peekware/PLFM_RADAR/README.md

# AERIS-10 — Açık Kaynak Faz Dizili RADAR Sistemi

10.5 GHz frekansta çalışan, Darbe Doğrusal Frekans Modülasyonlu (PLFM) faz dizili radar sistemi. İki versiyonda mevcuttur: 3 km ve 20 km menzil. Araştırmacılar, drone geliştiriciler ve SDR meraklıları için tasarlanmış düşük maliyetli açık kaynak platform.

## Özellikler

- **Frekans:** 10.5 GHz (X-Band)
- **Modülasyon:** Darbe Doğrusal Frekans Modülasyonu (LFM)
- **Menzil:** 3 km (düşük güç) / 20 km (yüksek güç)
- **Anten:** 16 elemanlı faz dizili anten array
- **Açık Donanım:** CERN-OHL-P lisanslı

## Proje Yapısı

```
1_Project_Description/          — proje açıklaması ve teknik detaylar
2_Functional Diagram/           — fonksiyonel diyagram ve bağlantı matrisleri
3_Power Management/             — güç yönetimi tasarımı
4_Schematics and Boards/        — şematikler ve PCB yerleşim dosyaları
5_Simulations/                  — RF ve sinyal simülasyonları
6_Application Notes/            — uygulama notları
7_Components Datasheets/        — bileşen datasheetleri
8_Utils/                        — yardımcı araçlar ve görseller
```

## Lisans

- Donanım: CERN-OHL-P v2
- Yazılım: MIT

---

## İletişim

Discord: [https://discord.gg/CNtdPshppv](https://discord.gg/CNtdPshppv)
