peekware/PLFM_RADAR/4_Schematics and Boards Layout/4_7_Production Files/Frequency_Synthesizer/th_.xlsx

JP1 |  | 2X06 | 15.090 | 17.400 | 180.0 | TOP
JP2 |  | 2X07 | 88.550 | 65.980 | 90.0 | TOP
X10 | 22-23-2021 | 22-23-2021 | 4.800 | 30.700 | 270.0 | TOP
X11 | 22-23-2021 | 22-23-2021 | 29.400 | 3.800 | 0.0 | TOP
X12 | 22-23-2021 | 22-23-2021 | 87.800 | 4.100 | 0.0 | TOP
X13 | 22-23-2021 | 22-23-2021 | 12.400 | 95.200 | 180.0 | TOP
X14 | 22-23-2021 | 22-23-2021 | 42.100 | 95.300 | 180.0 | TOP
X15 | 22-23-2021 | 22-23-2021 | 94.000 | 84.500 | 90.0 | TOP
J3 | CJT-T-P-HH-ST-TH1 | CONN_CJT-T-P-XX-ST-TH1_SAI | 78.870 | 47.710 | 270.0 | TOP
J4 | CJT-T-P-HH-ST-TH1 | CONN_CJT-T-P-XX-ST-TH1_SAI | 78.870 | 40.250 | 270.0 | TOP
