peekware/PLFM_RADAR/(commit log)

2026-03-13 refactor(firmware): name adar power sequencing constants
2026-03-13 fix(firmware): propagate gy85 i2c failures
2026-03-15 Fix 6 RTL bugs in FPGA signal processing chain
    - nco_400m_enhanced.v: Correct sine LUT values (3.7x quadrature error)
    - ddc_400m.v: Fix wire forward-declaration (Verilog-2001 compliance)
    - plfm_chirp_controller.v: Remove multi-driven chirp_counter (critical)
    - radar_system_top.v: Fix CFAR wire-as-reg, connect chirp_counter to receiver
    - radar_receiver_final.v: Promote chirp_counter to input port
    All fixes verified with Icarus Verilog 13.0 testbenches (144/144 tests pass).
2026-03-15 Add 8 Verilog testbenches with full coverage (144/144 pass)
    Testbenches for: edge_detector (17), nco_400m (20), cic_decimator (14),
    fir_lowpass (13), freq_matched_filter (14), ddc_400m full-chain (7),
    chirp_controller (39), chirp_contract regression (20).
    Includes CSV output data for waveform verification.
    Add .gitignore to exclude VCD/VVP build artifacts.
2026-03-15 Add 3 missing FPGA modules with enhanced testbenches (168/168 pass)
    Implement the 3 modules identified as missing during repo audit:
    - matched_filter_processing_chain: behavioral FFT-based pulse compression
    - range_bin_decimator: 1024→64 bin decimation with 3 modes + start_bin
    - radar_mode_controller: 4-mode beam/chirp controller
    Wire radar_mode_controller into radar_receiver_final.v to drive the
    previously-undriven use_long_chirp and mc_new_* signals.
    Implement start_bin functionality in range_bin_decimator (was dead code
    in the original interface contract — now skips N input bins before
    decimation for region-of-interest selection).
    Add comprehensive testbenches with Tier 1 confidenc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
2026-03-15 Fix synthesis blockers in 9 RTL files for Vivado compatibility
    Guard all $display/$error/$time calls with ifdef SIMULATION in:
    - chirp_memory_loader_param.v (initial + always block debug prints)
    - cic_decimator_4x_enhanced.v (5 saturation/overflow displays + monitor block)
    - ddc_400m.v (FIR/baseband debug monitor block)
    - fft_1024_inverse.v (IFFT config debug block)
    - matched_filter_multi_segment.v (16 state machine displays + monitor)
    - nco_400m_enhanced.v (initial block debug print)
    - radar_receiver_final.v (frame/chirp counter displays)
    Replace SystemVerilog constructs with Verilog-2001:
    - usb_data_interface.v (typedef enum -> localparam + reg)
    - usb_packet_analyzer.v (typedef enum -> lo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
2026-03-15 Fix 6 RTL files + add xfft_32 stub for successful Vivado synthesis
    Resolves all synthesis errors across attempts 3-11, achieving clean
    Vivado 2025.2 synthesis on XC7A100T (0 errors, 831 LUTs, 320 FFs, 2 DSPs).
    radar_receiver_final.v:
    - reg clk_400m -> wire; output reg -> output wire (x4)
    - Replace ad9484_lvds_to_cmos_400m with ad9484_interface_400m
    - Remove duplicate IBUFDS lvds_to_cmos_400m instantiation
    - Remove non-existent ref_i/ref_q port connections on matched filter
    - Connect adc_dco_bufg as 400MHz clock source
    ad9484_interface_400m.v:
    - Add adc_dco_bufg output port with BUFG instance
    - Route all internal logic through buffered DCO clock
    cic_decimator_4x_enhanced.v:
    - Move reset_mo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
2026-03-15 Fix CDC timing violations: add synchronizers for all inter-clock crossings
    Resolve all 4 inter-clock timing violations found in Vivado synthesis
    attempt #11 (WNS was -2.552 ns). Changes:
    - Add reset synchronizer for clk_120m_dac domain (2-FF chain)
    - Add Gray-code CDC for chirp_counter (6-bit, 120MHz->100MHz)
    - Add single-bit CDC for new_chirp_frame (3-stage, 120MHz->100MHz)
    - Add 2-stage input synchronizers for valid signals in USB module
    (clk_100m->ft601_clk_in) with data capture on rising edge
    - Fix ft601_clk_out multi-driven net (removed duplicate assignment)
    - Update XDC: set_max_delay -datapath_only for CDC, false_path for reset
    Result: Vivado attempt #12 passes with 0 errors, 0 ti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
2026-03-15 Achieve timing closure: DSP48E1 pipelines, 4-stage NCO, 28-bit CIC, ASYNC_REG
    Phase 0+ timing optimization (attempts #13-22 + implementation):
    NCO (nco_400m_enhanced.v):
    - 4-stage pipeline: DSP48E1 accumulate -> LUT read -> negate -> quadrant MUX
    - DSP48E1 phase accumulator in P=P+C mode (eliminates 8-stage CARRY4 chain)
    - Registered phase_inc_dithered to break cascaded 32-bit add path
    DDC (ddc_400m.v):
    - Direct DSP48E1 instantiation for I/Q mixers (AREG=1, BREG=1, MREG=1, PREG=1)
    - CEP=1, RSTP=!reset_n for proper pipeline control
    - 3-stage dsp_valid_pipe for PREG=1 latency
    - Behavioral sim model under ifdef SIMULATION for Icarus compatibility
    CIC (cic_decimator_4x_enhanced.v):
    - 28-bit a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
2026-03-16 Achieve full timing closure on xc7a100tcsg324-1 at 400 MHz (0 violations)
    Complete FPGA timing closure across all clock domains after 9 iterative
    Vivado builds. WNS improved from -48.325ns to +0.018ns (107,886 endpoints).
    RTL fixes for 400 MHz timing:
    - NCO: 6-stage pipeline with DSP48E1 phase accumulator, registered LUT
    index (Fix D splits address decode from ROM read), distributed RAM
    - CIC: explicit DSP48E1 PCOUT->PCIN cascade for 5 integrator stages,
    CREG=1 on integrator_0 to eliminate fabric->DSP setup violation
    - DDC: 400 MHz reset synchronizer (async-assert/sync-deassert),
    active-high reset register for DSP48E1 RST ports, posedge output stage
    - FIR: 5-stage binary adder tree pi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
2026-03-16 Add Phase 0.5 DDC co-simulation suite: bit-accurate Python model, scene generator, and 5/5 scenario validation
    Bit-accurate Python model (fpga_model.py) mirrors full DDC RTL chain:
    NCO -> mixer -> CIC -> FIR with exact fixed-point arithmetic matching
    RTL DSP48E1 pipeline behavior including CREG=1 delay on CIC int_0.
    Synthetic radar scene generator (radar_scene.py) produces ADC test
    vectors for 5 scenarios: DC, single target (500m), multi-target (5),
    noise-only, and 1 MHz sine wave.
    DDC co-sim testbench (tb_ddc_cosim.v) feeds hex vectors through RTL
    DDC and exports baseband I/Q to CSV. All 5 scenarios compile and run
    with Icarus Verilog (iverilog -g2001 -DSIMULATION).
    Comparison framework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
2026-03-16 Add matched-filter co-simulation: bit-perfect validation of Python model vs synthesis-branch RTL (4/4 scenarios, correlation=1.0)
2026-03-16 Fix ddc_input_interface 18->16 bit overflow: add saturation at positive full scale
    Bug: rounding logic 'adc_i <= ddc_i[17:2] + ddc_i[1]' overflows when
    ddc_i[17:2]=0x7FFF and ddc_i[1]=1, causing 0x7FFF+1=0x8000 (sign flip
    from max positive to most negative value).
    Fix: add explicit saturation — clamp to 0x7FFF when truncated value is
    max positive and round bit is set. Negative values cannot overflow since
    rounding only moves toward zero.
    New testbench: tb_ddc_input_interface.v with 26 tests covering rounding,
    truncation, overflow saturation at positive boundary, negative full scale,
    valid synchronization, and sync error detection.
2026-03-16 Fix multi-seg/chain handshake deadlock + add radar_receiver_final integration test (10/10 PASS)
    RTL fix: matched_filter_multi_segment.v ST_WAIT_FFT now waits for
    processing chain to complete ALL 1024 outputs and return to IDLE
    before advancing to next segment. Previously, it transitioned on the
    first fft_pc_valid edge, causing the chain to still be outputting
    while multi-seg started collecting data for the next segment. This
    broke the handshake and caused permanent deadlock after segment 0.
    Also fixes forward reference of sample_addr_from_chain in
    radar_receiver_final.v (declaration moved before first use).
    New files:
    - tb/tb_radar_receiver_final.v: P0 integration test for full RX
    pipeli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
2026-03-16 Fix RTL Bug #3: S_IDLE->S_ACCUMULATE now writes first sample immediately
    Previously the S_IDLE->S_ACCUMULATE transition consumed one data_valid
    cycle without writing to BRAM, losing the first sample. The testbench
    worked around this by sending sample[0] twice.
    Fix: drive mem_we + data capture in S_IDLE on the transition cycle and
    advance write_range_bin to 1. Testbench workaround removed.
    Verified: 3/3 Doppler co-sim BIT-PERFECT, integration test 10/10 PASS.
2026-03-16 Fix overlap-save: fill full 1024-sample buffer per segment, zero-pad last partial segment
    Previously segment 0 only filled positions [0:895], leaving [896:1023]
    as zeros from the initial block. These zeros propagated into the overlap
    region of subsequent segments, corrupting the convolution.
    Fix: change buffer-full threshold from SEGMENT_ADVANCE (896) to
    BUFFER_SIZE (1024). Add zero-padding for the last segment when chirp
    data runs out before the buffer is full. Updated testbench accordingly.
    Verified: multi-segment 32/32 PASS, integration test 10/10 PASS.
2026-03-16 Fix P0/P1 RTL bugs found during pre-hardware audit
    P0-1: nco_400m_enhanced.v — DSP48E1 OPMODE corrected from PCIN to P
    feedback (was routing stale cascade data into accumulator)
    P0-2: radar_receiver_final.v — removed same-clock CDC that corrupted
    ADC data path between ad9484_interface and DDC
    P1-5: fir_lowpass.v — fixed zero replication count in coefficient
    symmetric extension ({0{1'b0}} is empty, now uses explicit 0)
    Also updates .gitignore to exclude debug/scratch artifacts.
    All 30+ testbenches pass (unit, co-sim, integration).
2026-03-16 Migrate hardware platform from XC7A50T to XC7A200T-2FBG484I
    Production FPGA: Artix-7 XC7A200T-2FBG484I (33,650 slices, 740 DSP48E1,
    365 BRAM, -2 speed grade). Pin-mapped across 6 banks with proper VCCO
    assignment (3.3V/2.5V/1.8V).
    RTL timing primitives added for clean timing closure:
    - ad9484_interface_400m.v: BUFIO for IDDR capture at 400MHz DDR,
    BUFG for fabric logic, reset synchronizer (P1-7)
    - dac_interface_single.v: ODDR for dac_clk forwarding + dac_data[7:0]
    output registration, eliminates clock-forwarding insertion delay
    - usb_data_interface.v: ODDR for ft601_clk_out forwarding, FSM runs
    on ft601_clk_in domain with CDC synchronizers
    Constraints:
    - New production XDC (xc7a200t_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
2026-03-16 Fix XDC for timing closure: add hold waivers, remove stale constraints
    Build 3 on XC7A200T-2FBG484I achieves full timing closure:
    - WNS +0.040ns (setup), WHS +0.036ns (hold), 0 failing endpoints
    - Add 3 hold false-path waivers for ODDR/BUFIO I/O boundaries
    (DAC clk_120m→dac_clk_fwd, FT601 ft601_clk_in→ft601_clk_fwd,
    ADC adc_d_p→adc_dco_p) — all artifacts of STA modeling
    - Comment out ft601_be[2:3] pins (RTL only drives [1:0])
    - Remove CIC multicycle paths (DSP48E1 cells not matchable)
    - Add -quiet to IOB properties for tristate/optimized registers
2026-03-16 Widen ft601_be to [3:0] for 32-bit FT601 mode, fix NCO XSim TB
    - Expand ft601_be from [1:0] to [3:0] across RTL, top-level, testbenches,
    and XDC (uncomment be[2:3] pin assignments B21/A21)
    - Fix NCO XSim testbench: correct reset check (0x7FFF not 0), add pipeline
    warmup and sample skip for DSP48E1 quadrature test
    - All local regression tests pass (39/39 USB, 10/10 integration, all co-sim)
2026-03-16 Fix NCO XSim test 12: add pipeline warmup and sample skip for 1 MHz zero-crossing test
2026-03-17 Added all boards stack
2026-03-17 Add SymbiYosys formal verification for 6 modules, fix 2 doppler bugs
    Formal verification (SymbiYosys + smtbmc/z3):
    - cdc_single_bit: BMC PASS depth 80, cover PASS 3/3
    - cdc_handshake: BMC PASS depth 100, cover PASS 4/4
    - cdc_adc_to_processing: BMC PASS depth 80, cover PASS
    - radar_mode_controller: BMC PASS depth 200, cover PASS 8/8
    - range_bin_decimator: cover PASS 7/7, BMC running (step 61+)
    - doppler_processor: cover running (step 133/150), BMC running (step 35+)
    DUT bug fixes found by formal:
    - doppler_processor: write_chirp_index overflow past CHIRPS_PER_FRAME-1
    in S_ACCUMULATE frame-complete branch (reset to 0)
    - doppler_processor: read_doppler_index unclamped prefetch in S_LOAD_FFT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
2026-03-17 Fix all 10 CDC bugs from report_cdc audit, add overflow guard in range_bin_decimator
    CDC fixes across 6 RTL files based on post-implementation report_cdc analysis:
    - P0: sync stm32_mixers_enable and new_chirp_pulse to clk_120m via toggle CDC
    in radar_transmitter, add ft601 reset synchronizer and USB holding
    registers with proper edge detection in usb_data_interface
    - P1: add ASYNC_REG to edge_detector, convert new_chirp_frame to toggle CDC,
    fix USB valid edge detect to use fully-synced signal
    - P2: register Gray encoding in cdc_adc_to_processing source domain, sync
    ft601_txe and stm32_mixers_enable for status_reg in radar_system_top
    - Safety: add in_bin_count over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
2026-03-17 Fix range_bin_decimator overflow guard priority bug: group completion now takes precedence over overflow guard in ST_PROCESS, ensuring all OUTPUT_BINS outputs are emitted when sufficient input sample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
2026-03-17 Fix CDC reset domain bug (P0), strengthen testbenches with 31 structural assertions
    Split cdc_adc_to_processing reset_n into src_reset_n/dst_reset_n so source
    and destination clock domains use correctly-synchronized resets. Previously
    cdc_chirp_counter's destination-side sync chain (100MHz) was reset by
    sys_reset_120m_n (120MHz domain), causing 30 CDC critical warnings.
    RTL changes:
    - cdc_modules.v: split reset port, source logic uses src_reset_n,
    destination sync chains + output logic use dst_reset_n
    - radar_system_top.v: cdc_chirp_counter gets proper per-domain resets
    - ddc_400m.v: CDC_FIR_i/q use reset_n_400m (src) and reset_n (dst)
    - formal/fv_cdc_adc.v: updated wrapper for new port i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
2026-03-17 Convert async→sync reset on DSP/BRAM datapath registers for timing closure
    P1-CRITICAL: doppler_processor.v — split FSM into control (async reset)
    and BRAM/DSP datapath (sync reset) blocks. Fixes REQP-1839/1840 BRAM
    address register corruption risk; enables DSP48 absorption of window
    multipliers (mult_i/q).
    P1-CRITICAL: frequency_matched_filter.v — convert all 4 pipeline stages
    (input capture, multiply, add, saturate) from async to sync reset.
    Enables DSP48E1 absorption of complex multiplier registers.
    P1-HIGH: fir_lowpass.v — convert adder tree (L0-L4), output stage, and
    valid pipeline from async to sync reset. Fixes 856 DPOR-1 warnings
    (428 per FIR instance × 2 I/Q channels), en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
2026-03-17 Split fft_engine FSM: async reset for control, sync reset for DSP/BRAM datapath (Build 11)
    Split monolithic always block into two:
    - Block 1 (async reset): FSM state, counters, output interface
    (dout_re/im, dout_valid, done) — deterministic startup
    - Block 2 (sync reset): DSP/BRAM pipeline registers (rd_b_re/im,
    rd_tw_cos/sin, bf_prod_re/im, rd_a_re/im, bf_t_re/im, rd_tw_idx,
    rd_addr_even/odd, rd_inverse) — enables hard block absorption
    Also convert output pipeline (out_pipe_valid/inverse) to sync reset.
    Expected synthesis impact:
    - DSP48E1 AREG/BREG absorption for butterfly multiply inputs
    - DSP48E1 PREG absorption for multiply outputs (bf_prod_re/im)
    - BRAM output register abso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
2026-03-17 Improve timing margins with targeted datapath register tuning
    Reduce routing pressure on CIC/NCO critical paths and move Doppler BRAM read-address registers to sync-reset datapath logic so Build 13 closes with stronger setup/hold slack while preserving functional behavior.
2026-03-17 Phase 1 hardware bring-up prep: ILA debug probes, CDC waivers, programming scripts
    - Rename latency_buffer_2159 -> latency_buffer (module + file + all refs)
    - Add CDC waivers for 5 verified false-positive criticals to XDC
    - Add ILA debug probe insertion script (4 cores, 126 probe bits, 2 clock domains)
    - Add FPGA programming script (7-step flow with DONE pin verification)
    - Add ILA capture script (4 scenarios + health check, CSV export)
    - Add debug_ila.xdc with MARK_DEBUG fallback attributes
    - Full regression clean: 13/13 suites, 266/266 checks, 2048/2048 golden match
2026-03-18 Fix ILA probe insertion script: deferred core creation, exact-path net resolution, Vivado 2025.2 MU_CNT minimum
2026-03-18 Add TE0712/TE0701 split target with dedicated top, XDC, and build flow
2026-03-18 Add GitHub Pages docs site for antenna and simulation reports
2026-03-18 Publish Simulation Report v2 aligned to current FPGA baseline
2026-03-19 Add bring-up diagnostic instrumentation to clocking/LO subsystem and main init
    Observe-before-fix instrumentation for bench bring-up: adds timestamped
    DIAG logging to the AD9523 clock config, ADF4382A LO manager, power
    sequencing, lock monitoring, temperature monitoring, and safe-mode entry.
    Annotates known bugs (double ad9523_setup call, timed-sync init ordering,
    TriggerTimedSync no-op, phase-shift before init-check, last_check timer
    collision) without changing any runtime behavior.
2026-03-19 Add DIAG instrumentation to beamformer, PA, USB, and remaining main.cpp subsystems
    Completes the observe-before-fix instrumentation pass across all critical
    firmware subsystems:
    - ADAR1000_Manager.cpp: 99 DIAG calls covering power-up/down, TX/RX mode
    switching, ADTR1107 init sequence, SPI transfers, ADC reads (with 100ms
    timeout guard on unbounded busy-wait), and scratchpad verification.
    - DA5578.c: 21 DIAG calls on init, reset, channel writes, clear pin
    activation, and I2C error paths.
    - ADS7830.c: DIAG on init (with test-read verification) and I2C
    transmit/receive error logging in single-ended and differential reads.
    - USBHandler.cpp: DIAG on state transitions, start flag detectio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
2026-03-19 Add MCU firmware test harness with 8 bug-confirming tests
    Complete test infrastructure for the observe-before-fix methodology:
    - stm32_hal_mock: HAL stub types + spy/recording ring buffer (512 entries)
    - ad_driver_mock: ADF4382/AD9523 mock drivers with configurable returns
    - 9 shim headers redirecting real #includes to mock types
    - Makefile with individual (test_bug1..8) and aggregate (test) targets
    All 8 tests pass, confirming:
    #1 Timed sync init ordering (SetupTimedSync before initialized=true)
    #2 AD9523 double setup (first call before reset release)
    #3 TriggerTimedSync no-op (prints messages, no HW action)
    #4 Phase shift before init error check
    #5 SetFinePhaseShift GPIO-only p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
2026-03-19 Fix all 8 firmware bugs with regression tests
    Bugs fixed in adf4382a_manager.c:
    - Bug #1: Move initialized=true before sync setup, propagate sync failure
    - Bug #3: Implement TriggerTimedSync with sw_sync pulse (was no-op)
    - Bug #5: Replace GPIO-only placeholder with TIM3 PWM for DELADJ
    - Bug #7: Correct GPIOG pin definitions to match CubeMX (pins 6-15)
    Bugs fixed in main.cpp:
    - Bug #2: Remove pre-reset ad9523_setup() call (keep only post-reset)
    - Bug #4: Move init error check before phase shift calls
    - Bug #6: Fix timer variable (last_check -> last_check1) in temp block
    - Bug #8: Uncomment uart_print/uart_println debug helpers
    Test harness updates:
    - All 8 tests rewritten to assert correct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
2026-03-19 Fix SPI bugs #9 (NULL platform_ops) and #10 (missing CS toggle), widen chip_select to uint16_t
    Bug #9: Both TX and RX SPI init params had platform_ops = NULL, causing
    adf4382_init() -> no_os_spi_init() to fail with -EINVAL. Fixed by setting
    platform_ops = &stm32_spi_ops and passing stm32_spi_extra with correct CS
    port/pin for each device.
    Bug #10: stm32_spi_write_and_read() never toggled chip select. Since TX
    and RX ADF4382A share SPI4, every register write hit both PLLs. Rewrote
    stm32_spi.c to assert CS LOW before transfer and deassert HIGH after,
    using stm32_spi_extra metadata. Backward-compatible: legacy callers
    (e.g., AD9523) with cs_port=NULL skip CS management.
    Also widened chip_sele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
2026-03-19 Fix Bug #11 (platform SPI transmit-only), FPGA B2 (chirp BRAM migration), FPGA B3 (DSP48 pipelining)
    Bug #11: platform_noos_stm32.c used HAL_SPI_Transmit instead of
    HAL_SPI_TransmitReceive — reads returned garbage. Changed to in-place
    full-duplex. Dead code (never called), fixed per audit recommendation.
    Test added: test_bug11_platform_spi_transmit_only.c. Mock infrastructure
    updated with SPI spy types. All 11 firmware tests pass.
    FPGA B2: Migrated long_chirp_lut[0:3599] from ~700 lines of hardcoded
    assignments to BRAM with (* ram_style = "block" *) attribute and
    $readmemh("long_chirp_lut.mem"). Added sync-only read block for proper
    BRAM inference. 1-cycle read latency introduced. short_c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
2026-03-19 Fix bugs B12-B17 (PA cal loop, ADC buffer, DIAG_SECTION args, htim3 init, stale annotations) with regression tests
    B12: PA IDQ calibration loop condition inverted (< 0.2 -> > 0.2) for both DAC1/DAC2
    B13: DAC2 ADC buffer mismatch — reads from hadc2 now correctly stored to adc2_readings
    B14: DIAG_SECTION macro call sites changed from 2-arg to 1-arg form (4 sites)
    B15: htim3 definition + MX_TIM3_Init() added (PWM mode, CH2+CH3, Period=999)
    B16: Removed stale NO-OP annotation on TriggerTimedSync (already fixed in Bug #3)
    B17: Updated stale GPIO-only warnings to reflect TIM3 PWM implementation (Bug #5)
    All 15 tests pass (11 original + 4 new for B12-B15).
2026-03-19 CIC comb pipeline registers, BUFG sim guard, system TB fix, regression runner
    - cic_decimator_4x_enhanced.v: Add integrator_sampled_comb and
    data_valid_comb_pipe pipeline stages between integrator sampling and
    comb computation to break the critical path (matches remote 40cda0f)
    - radar_system_top.v: Wrap 3 BUFG instances in ifdef SIMULATION guard
    with pass-through assigns for iverilog compatibility
    - radar_system_tb.v: Convert generate_radar_echo function to task and
    move sin_lut declaration before task (iverilog declaration-order fix),
    add modular index clamping to prevent LUT out-of-bounds
    - run_regression.sh: Automated regression runner for all 18 FPGA
    testbenches with --quick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
2026-03-19 Fix matched filter golden test paths (40/40 pass, was 37/40)
2026-03-19 Wire matched filter range profile to USB, replacing Doppler placeholder
2026-03-19 Add board-day worksheet and cross-link bring-up docs
2026-03-19 Add FMC-path FT601 XDC for TE0713+TE0701+UMFT601X-B pin mapping
    Maps all 47 FT601 signals through FMC LPC J10 to correct FPGA pins:
    - DATA[31:0] + D_CLK: Bank 15 (LA17-LA33)
    - BE_N[3:0], control, status: Bank 16 (LA00-LA15)
    Both banks share VIOTB rail — set to 3.3V for LVCMOS33.
    Includes timing constraints and RTL adaptation notes.
2026-03-19 Add UART diagnostic capture tool for board-day bring-up
    - Python/pyserial script captures STM32 USART3 DIAG output (115200 8N1)
    - Auto-detects serial port on macOS (ST-Link VCP, FTDI, CH340, CP210x)
    - Color-coded terminal output by subsystem and severity
    - Simultaneous logging to timestamped file in logs/
    - Filtering by subsystem tag (--filter LO,PA) or severity (--errors-only)
    - Parses all DIAG macro formats: DIAG, DIAG_WARN, DIAG_ERR, DIAG_SECTION
    - Capture stats summary on exit (line counts by subsystem, error/warning totals)
    - logs/ added to .gitignore
2026-03-19 Update heartbeat dev target: LVCMOS33 for Bank 16 FT601 compat, add comments
    - Changed user_led/system_status IOSTANDARD from LVCMOS25 to LVCMOS33
    to match VIOTB=3.3V needed for FT601 on Bank 16
    - Added register init value for hb_counter
    - Added comments documenting clock source (50 MHz FIFO0CLK at U20, Bank 14)
    and expected LED toggle rates
2026-03-19 Update ILA probe script references from Build 13 to Build 16
2026-03-19 FIR DSP48 pipelining (BREG+MREG) + matched filter BRAM migration with overlap cache
    FIR: Add coeff_reg/mult_reg pipeline stages to fix 68 DPIP-1 + 35 DPOP-2
    DRC warnings. Valid pipeline widened 7→9 bits (+2 cycle latency).
    Matched filter: Migrate input_buffer_i/q from register arrays to BRAM
    (~33K FF savings). Overlap-save uses register cache captured during
    ST_PROCESSING to avoid BRAM read/write conflicts during overlap copy.
    New ST_OVERLAP_COPY state writes cached tail samples back sequentially.
    Both changes pass 18/18 FPGA regression. Golden data regenerated for
    +2 FIR latency baseline.
2026-03-19 Fix matched filter synth errors: overlap_copy_count part-select width, add FSM default
    Vivado 2025.2 (Synth 8-524): overlap_copy_count is 8-bit but [9:0]
    part-select was 10-bit. Changed to explicit zero-extend concat.
    Added default case to FSM to suppress non-full case warning.
2026-03-19 Add Phase 0 Vivado-style lint to regression runner, update golden data
    Adds two-layer lint pass (iverilog -Wall + custom static checks) that
    catches part-select OOB errors and case-without-default warnings before
    pushing to remote Vivado. Catches the exact Synth 8-524 class error that
    broke Build 18 initial attempt. Lint errors abort regression; warnings
    are advisory. Regenerated golden data for BRAM-migrated matched filter.
2026-03-19 Gap 3 Safety Architecture: IWDG watchdog, Emergency_Stop PA rail cutoff, temp max, periodic IDQ re-read, emergency state ordering + 5 tests (20/20 pass)
2026-03-19 Gap 7 MMCM jitter cleaner + CIC comb CREG pipeline + XDC clock-name fix
    MMCM (Gap 7):
    - Add adc_clk_mmcm.v: MMCME2_ADV wrapper (VCO=800MHz, CLKOUT0=400MHz)
    - Modify ad9484_interface_400m.v: replace BUFG with MMCM path, gate reset on mmcm_locked
    - Add adc_clk_mmcm.xdc: CDC false paths for clk_mmcm_out0 <-> clk_100m
    XDC Fix (Build 19 WNS=-0.011 root cause):
    - Remove conflicting create_generated_clock -name clk_400m_mmcm
    - Replace all clk_400m_mmcm references with Vivado auto-generated clk_mmcm_out0
    - CDC false paths now correctly apply to actual timing paths
    CIC CREG Pipeline (Build 18 critical path fix):
    - Explicit DSP48E1 for comb[0] with CREG=1/AREG=1/BREG=1/PREG=1
    - Absorbs integrator_sa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
2026-03-19 Gap 4 USB Read Path: wire host-to-FPGA command path with toggle CDC, add read path tests
    - usb_data_interface.v: Add FT601 read FSM (RD_IDLE/OE_ASSERT/READING/
    DEASSERT/PROCESS) + cmd_data/valid/opcode/addr/value output ports
    - radar_system_top.v: Connect cmd_* ports from usb_inst, add toggle CDC
    for cmd_valid (ft601_clk -> clk_100m), add command decode registers
    (mode/trigger/cfar_threshold/stream_control), wire host_mode and
    host_trigger to rx_inst
    - radar_receiver_final.v: Add host_mode[1:0] and host_trigger input
    ports, replace hardcoded mode/trigger in radar_mode_controller instance
    - tb_usb_data_interface.v: Connect cmd_* ports, add host data bus driver,
    add Test Groups 12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
2026-03-19 Update docs for Build 20 (v0.1.3-build20) stable release + Gaps 3-7 status
    - release-notes.html: Add commits for Gaps 3-5-7-4, tagged releases table,
    architectural gap status table, updated GitHub links
    - implementation-log.html: Add Build 20/19/18 timeline entries, Gap 3-4-5
    milestones, updated quality/build history sections
    - reports.html: Update FPGA status to Build 20 baseline, MCU regression
    to 20/20, report currency notice with current gap status
2026-03-19 Gap 2 GUI Settings: runtime chirp timing, stream control gating, status readback (18/18 FPGA, 20/20 MCU)
    Register map: 0x10-0x15 chirp timing overrides, 0xFF status readback,
    0x03 CFAR threshold now wired to actual compare, 0x04 stream control
    gates USB write FSM. Status readback sends 7-word packet (0xBB header,
    5 status words, 0x55 footer) via toggle CDC.
    radar_mode_controller: 6 cfg_* input ports replace hardcoded parameters.
    usb_data_interface: stream_control CDC, status_request toggle CDC,
    SEND_STATUS state (3'd7), stream gating in IDLE/HEADER/RANGE/DOPPLER.
    radar_system_top: 6 host registers + command decode for 0x10-0x15/0xFF.
    radar_receiver_final: 6 host_* timing passthrough ports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
2026-03-19 FFT engine: merge SHIFT into WRITE (5→4 cycle butterfly, 20% throughput) + barrel-shift twiddle index
    Opt 1: Eliminated ST_BF_SHIFT state — arithmetic right-shift is pure
    bit-selection (zero logic levels), merged into BF_WRITE combinational
    add/subtract. Saves LOG2N * N/2 = 5120 cycles per 1024-pt FFT.
    Opt 2: Replaced idx_val * tw_stride_reg general multiply with
    idx_val << (LOG2N-1-stage) barrel shift. tw_stride_reg is always a
    power of 2, so this is mathematically identical and frees a multiplier.
    Regression: 18/18 FPGA pass (bit-exact results).
2026-03-19 E2E integration test + RTL fixes: mixer sequencing, USB data-pending flags, receiver toggle wiring (19/19 FPGA)
    RTL fixes discovered via new end-to-end testbench:
    - plfm_chirp_controller: TX/RX mixer enables now mutually exclusive
    by FSM state (Fix #4), preventing simultaneous TX+RX activation
    - usb_data_interface: stream control reset default 3'b001 (range-only),
    added doppler/cfar data_pending sticky flags, write FSM triggers on
    range_valid only — eliminates startup deadlock (Fix #5)
    - radar_receiver_final: STM32 toggle signals wired through for mode-00
    pass-through, dynamic frame detection via host_chirps_per_elev
    - radar_system_top: STM32 toggle signal wiring to receiver instan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
2026-03-19 Fix Vivado DRC: consolidate data_pending flags into single always block, fix MMCM LOCKED false_path
    usb_data_interface.v: doppler_data_pending and cfar_data_pending were
    driven by two always blocks (CDC sync block set them, write FSM cleared
    them). Vivado DRC MDRV-1 flagged this as multiple drivers. Moved all
    set/clear logic into the write FSM always block using doppler_valid_ft
    and cfar_valid_ft edge wires.
    adc_clk_mmcm.xdc: changed set_false_path -from to -through for MMCM
    LOCKED pin (not a valid timing startpoint). Eliminates CRITICAL WARNING
    from Builds 19/20/21.
    19/19 FPGA regression pass.
2026-03-20 Build 21 docs + TCL fix: WNS +0.156ns, 139 DSP, tag v0.1.4-build21
    Build 21 Vivado results extracted and documented:
    - WNS +0.156 ns, WHS +0.064 ns, WPWS +0.361 ns (all timing met)
    - 6,192 LUTs (4.6%), 9,064 FFs (3.4%), 16 BRAM (4.4%), 139 DSP48E1 (18.8%)
    - Total power: 0.732 W
    - Barrel-shift twiddle freed 1 DSP (140 -> 139) as expected
    - TCL script fix: wrap check_timing in catch (Vivado 2025.2 bug)
    - Updated release-notes.html, implementation-log.html, reports.html
2026-03-20 Real-data co-simulation: range FFT, Doppler, full-chain all 2048/2048 exact match
    ADI CN0566 Phaser 10.525 GHz X-band radar data validation:
    - golden_reference.py: bit-accurate Python model with range_bin_decimator
    - tb_range_fft_realdata.v: 1024/1024 exact match
    - tb_doppler_realdata.v: 2048/2048 exact match
    - tb_fullchain_realdata.v: decimator+Doppler 2048/2048 exact match
    - 19/19 FPGA regression unaffected
2026-03-20 Production fixes 1-7: detection bugs, cfar→threshold rename, digital gain control, Doppler mismatch protection, decimator watchdog, bypass_mode dead code removal, range-mode register (21/21 regressio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
    Fix 1: Combinational magnitude + non-sticky detection flag (tb: 23/23)
    Fix 2: Rename all cfar_* signals to detect_*/threshold_* (honest naming)
    Fix 3: New rx_gain_control.v between DDC and FFT, opcode 0x16 (tb: 33/33)
    Fix 4: Clamp host_chirps_per_elev to DOPPLER_FFT_SIZE, error flag (E2E: 54/54)
    Fix 5: Decimator watchdog timeout, 256-cycle limit (tb: 63/63)
    Fix 6: Remove bypass_mode dead code from ddc_400m.v (DDC tb: 21/21)
    Fix 7: Range-mode register 0x20 with status readback (USB tb: 7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
2026-03-20 Integrate CA-CFAR detector: replace fixed-threshold comparator with adaptive sliding-window CFAR engine (22/22 regression PASS)
    - Add cfar_ca.v: CA/GO/SO-CFAR with BRAM magnitude buffer, host-configurable
    guard cells, training cells, alpha multiplier, and mode selection
    - Replace old threshold detector block in radar_system_top.v with cfar_ca
    instantiation; backward-compatible (cfar_enable defaults to 0)
    - Add 5 new host registers: guard (0x21), train (0x22), alpha (0x23),
    mode (0x24), enable (0x25)
    - Expose doppler_frame_done_out from radar_receiver_final for CFAR frame sync
    - Add tb_cfar_ca.v standalone testbench (14 tests, 24 checks)
    - Add Group 14 E2E tests: 13 checks covering rang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
2026-03-20 Pipeline CFAR noise computation: break critical path for timing closure
    Split ST_CFAR_THR into two pipeline stages (THR + MUL) to fix Build 23
    timing violation (WNS = -0.309 ns). The combinational path from
    leading_sum through GO/SO cross-multiply into alpha*noise DSP was too
    long for 10 ns.
    New pipeline:
    ST_CFAR_THR: register noise_sum_comb (mode select + cross-multiply)
    ST_CFAR_MUL: compute alpha * noise_sum_reg in DSP
    ST_CFAR_CMP: compare + update window (unchanged)
    3 cycles per CUT instead of 2 (~85 us vs 70 us per frame, negligible).
    All detection results identical: 23/23 CFAR standalone, 22/22 full
    regression, 3/3 real-data co-sim (5137/5137 exact match) PASS.
2026-03-20 Add Build 24 15-point engineering report: timing, utilization, DSP/BRAM breakdown, power, DRC, methodology, congestion, routing, logic levels, build comparison, CFAR cost, verification summary
2026-03-20 Integrate MTI canceller and DC notch filter for ground clutter removal
    MTI canceller (2-pulse, H(z)=1-z^{-1}) between range decimator and
    Doppler processor. Subtracts previous chirp from current, nulling DC
    Doppler (stationary clutter). Pass-through when host_mti_enable=0.
    DC notch filter (post-Doppler, pre-CFAR) zeros bins within
    +/-host_dc_notch_width of DC. Complements MTI for residual clutter.
    New host registers: 0x26 (mti_enable), 0x27 (dc_notch_width).
    Both default to 0 (disabled) - fully backward-compatible.
    Verification: 23/23 regression, 29/29 MTI standalone, 3/3 real-data
    co-sim (5137/5137 exact match) all PASS.
2026-03-20 Full-chain MTI+CFAR real-data co-simulation: bit-exact match across all 10247 checkpoints (decim->MTI->Doppler->DC notch->CFAR) using ADI CN0566 data
2026-03-20 Fix 5 GUI bugs: threaded connect, button toggle, live CFAR/MTI/DC replay, stable heatmap, physical axis labels
    - Bug 1: Move conn.open() to background thread to prevent GUI hang
    - Bug 2: Save btn_connect as instance var, toggle Connect/Disconnect text
    - Bug 3: Split opcodes into hardware-only (silent) and replay-adjustable
    (CFAR/MTI/DC-notch params trigger bit-accurate pipeline re-processing)
    - Bug 4: EMA-smoothed vmax (alpha=0.15), fftshift on Doppler axis
    - Bug 5: Physical axis labels (range in meters, velocity in m/s)
    - Add _replay_mti(), _replay_dc_notch(), _replay_cfar() standalone functions
    - Expand TestReplayConnection from 6 to 11 tests (42/42 pass)
2026-03-20 Wire self-test results (0x31) to USB status readback path, add fpga_self_test to regression
    - usb_data_interface.v: Add 3 self-test status inputs, expand status packet
    from 7 words (header + 5 data + footer) to 8 words (header + 6 data + footer).
    New status_words[5] carries {busy, detail[7:0], flags[4:0]}.
    - radar_system_top.v: Wire self_test_flags_latched, self_test_detail_latched,
    self_test_busy to usb_data_interface ports. Add opcode 0x31 as status
    readback alias so host can read self-test results.
    - tb_usb_data_interface.v: Add self-test port connections, verify word 5 in
    Group 16, add Group 18 (busy flag + partial failure variant). 81 checks pass.
    - run_regression.sh: Add fpga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
2026-04-06 fix(scripts): make Vivado TCL scripts portable and update RTL file lists
    - Replace hardcoded /home/jason-stone/ paths with [info script]-relative
    path resolution in all 9 scripts (build17-21, insert_ila_probes,
    program_fpga, ila_capture, run_cdc_and_netlist)
    - Point constraint references at tracked XDC files instead of
    untracked synth_only.xdc
    - Remove six phantom RTL entries (chirp_lut_init.v, fft_1024_forward.v,
    fft_1024_inverse.v, level_shifter_interface.v, lvds_to_cmos_400m.v,
    usb_packet_analyzer.v)
    - Add six existing modules to file lists (rx_gain_control.v,
    mti_canceller.v, cfar_ca.v, fpga_self_test.v, xfft_16.v,
    adc_clk_mmcm.v)
    Closes #38
2026-04-06 fix(rtl,gui,cosim,formal): adapt surrounding files for dual 16-pt FFT (follow-up to PR #33)
    - radar_system_top.v: DC notch now masks to dop_bin[3:0] per sub-frame so both sub-frames get their DC zeroed correctly; rename DOPPLER_FFT_SIZE → DOPPLER_FRAME_CHIRPS to avoid confusion with the per-FFT size (now 16)
    - radar_dashboard.py: remove fftshift (crosses sub-frame boundary), display raw Doppler bins, remove dead velocity constants
    - golden_reference.py: model dual 16-pt FFT with per-sub-frame Hamming window, update DC notch and CFAR to match RTL
    - fv_doppler_processor.sby: reference xfft_16.v / fft_twiddle_16.mem, raise BMC depth to 512 and cover to 1024
    - fv_radar_mode_controller.sby: rai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
2026-04-07 fix(scripts): fix TCL command substitution and impl status race in all 5 build scripts
    - Escape [extra] → \[extra\] to prevent TCL interpreting it as a command
    (Vivado resolved 'extra' to 'extract_files' causing ERROR [Common 17-163])
    - Fix implementation status check: accept 'write_bitstream' status as success
    (Vivado auto-proceeds to write_bitstream, making status != '*Complete*')
    - Wrap bitstream launch_runs in catch{} to handle already-running case
    Fixes applied to: build17, build18, build19, build20, build21
2026-04-07 fix(scripts,constraints): handle empty STATS properties in build summaries, fix 50T XDC DRC errors
    Build scripts (17-21): STATS.WNS/TNS/WHS/THS/TPWS from get_property can
    return empty strings in Vivado 2025.2 after write_bitstream auto-launch.
    Wrap in catch with N/A fallback. Guard all expr delta calculations and
    signoff comparisons with [string is double -strict] checks.
    XDC (xc7a50t_ftg256): Fix PLIO-9 by moving clk_120m_dac from C13 (N-type)
    to D13 (P-type MRCC) — clock inputs require P-type MRCC pin. Fix BIVC-1 by
    disabling DIFF_TERM on Bank 14 LVDS pairs to resolve VCCO conflict with
    single-ended adc_pwdn (LVCMOS33) on T5 — requires external termination.
2026-04-07 fix(rtl,constraints): change IBUFDS to IOSTANDARD DEFAULT for multi-target bank voltage compatibility
    The IBUFDS primitives in ad9484_interface_400m.v hardcoded LVDS_25 and
    DIFF_TERM TRUE, which overrode XDC constraints. On the XC7A50T (Bank 14
    VCCO=3.3V), this caused a BIVC-1 DRC error: LVDS_25 requires VCCO=2.5V,
    conflicting with adc_pwdn (LVCMOS33, VCCO=3.3V) in the same bank.
    Changes:
    - ad9484_interface_400m.v: IBUFDS parameters changed from LVDS_25/DIFF_TERM
    TRUE to DEFAULT/DIFF_TERM FALSE, delegating control to XDC per target
    - xc7a50t_ftg256.xdc: Re-enable DIFF_TERM TRUE (safe now that RTL does not
    hardcode LVDS_25), update DRC Fix History with correct root cause
2026-04-07 fix(constraints): use LVDS (not LVDS_33) for 50T Bank 14 ADC inputs
    LVDS_33 is not a valid I/O standard on 7-series FPGAs. The correct
    standard for LVDS inputs in HR banks with VCCO != 2.5V is LVDS, which
    works with any VCCO for input-only buffers (IBUFDS). LVDS_25 requires
    VCCO=2.5V exactly.
    Note: the 50T FTG256 build still fails at placement due to pin overflow
    (113 ports vs 69 available pins) — this is a pre-existing package
    limitation unrelated to this fix.
2026-04-07 fix(constraints,scripts): resolve 50T build failures — LVDS_25 + DRC waivers + unconstrained ports
    Three issues prevented the 50T (FTG256) build from completing:
    1. LVDS standard: LVDS_33 and LVDS do not exist on 7-series HR banks.
    Changed to LVDS_25 (the only valid differential input standard).
    IBUFDS inputs are VCCO-independent, so LVDS_25 works correctly even
    with Bank 14 VCCO=3.3V.
    2. BIVC-1 DRC: Bank 14 has LVDS_25 (needs 2.5V) and LVCMOS33 adc_pwdn
    (needs 3.3V). Since all LVDS ports are inputs (IBUFDS only), the
    voltage conflict does not affect functionality. Demoted to warning.
    3. Pin overflow: 113 ports vs 69 available FTG256 pins. The 118
    unconstrained port bi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
2026-04-07 fix(scripts): inject DRC waivers via TCL.PRE hook for impl_1 child process
    set_property SEVERITY in the parent Vivado process does not propagate
    to the child process spawned by launch_runs. Write a drc_waivers_50t.tcl
    hook and attach it via STEPS.OPT_DESIGN.TCL.PRE so BIVC-1, NSTD-1,
    and UCIO-1 are demoted to warnings inside the impl_1 run context.
2026-04-07 fix(constraints): change adc_pwdn from LVCMOS33 to LVCMOS25 for Bank 14 compatibility
    The placer enforces a single VCCO per bank. LVDS_25 forces Bank 14
    to VCCO=2.5V, which conflicts with LVCMOS33 (needs 3.3V). Changing
    adc_pwdn to LVCMOS25 resolves [Place 30-372] bank incompatibility.
    The AD9484 PWDN pin has CMOS-level thresholds (~0.8V), so 2.5V
    output drives it correctly.
2026-04-07 fix(scripts): switch 50T build to non-project-mode impl + remove unconstrained ports
    The 50T FTG256 has only 69 usable IO pins but the RTL declares 182 port
    bits. launch_runs spawns a child process that cannot remove ports.
    Switch to direct opt_design/place_design/route_design flow so we can
    remove 118 unconstrained ports (FT601 USB, dac_clk, status/debug) from
    the netlist before placement, avoiding [Place 30-58] IO overflow.
2026-04-07 feat(rtl): add radar_system_top_50t wrapper to solve IO pin overflow
    The XC7A50T-FTG256 has only 69 usable IO pins but radar_system_top
    declares 182 port bits. Previous attempts to remove unconstrained
    ports via TCL caused opt_design to cascade-remove all driving logic.
    New approach: radar_system_top_50t.v is a thin wrapper that:
    - Exposes only the 64 physically-connected ports (ADC, DAC, SPI, clocks)
    - Instantiates radar_system_top internally with full logic preserved
    - Ties off unused inputs (FT601 bus, ext trigger) to safe defaults
    - Leaves unused outputs internally connected (no IOBs created)
    Updated build_50t_test.tcl to use radar_system_top_50t as top module
    and removed the now-unnec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
2026-04-07 fix(rtl): add DONT_TOUCH attribute to prevent opt_design from gutting 50T wrapper
    Build attempt 10 produced a valid bitstream but with only 315 LUTs and
    15 DSPs — opt_design removed all logic feeding unconnected _nc wires.
    Adding (* DONT_TOUCH = "TRUE" *) on the u_core instance prevents
    Vivado from optimizing away the internal radar pipeline logic.
2026-04-07 fix(rtl): force FIR adder tree to fabric to free 30 DSPs for FFT butterfly on 50T
    Add (* USE_DSP = "no" *) attribute to FIR lowpass adder tree registers
    (add_l1, add_l2, add_l3, accumulator_reg) to prevent Vivado from
    inferring DSP48E1 slices for pure addition operations.
    Each fir_lowpass_parallel_enhanced instance was using 47 DSPs (32 for
    multiply + 15 for the adder tree). The 15 adder-tree DSPs per instance
    (30 total for I/Q pair) performed only PCIN+A:B additions with no
    multiplier usage. On the XC7A50T with only 120 DSP48E1 slices, this
    caused 100% DSP utilization and forced FFT butterfly complex multipliers
    to spill into 18-level fabric carry chains (WNS=-1.103ns).
    Moving these 36-bi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
2026-04-07 fix(xdc): add hold false_path for ADC IDDR + reorganize build scripts by target
    - Add set_false_path -hold for source-synchronous ADC IDDR paths in
    adc_clk_mmcm.xdc (eliminates 8 hold violations from build 12)
    - Add DDR falling-edge input delay constraints to xc7a50t_ftg256.xdc
    (parity with 200T XDC)
    - Reorganize scripts/ into target subdirectories: 50t/, 200t/, te0712/,
    te0713/, utils/ so users can run the correct build for their hardware
    - Delete obsolete build scripts (build17-20) superseded by build_50t/200t
    - Update project_root paths in all moved scripts (.. -> ../..)
2026-04-07 feat(usb): add FT2232H USB 2.0 interface for 50T production board
    Replace FT601 (USB 3.0, 32-bit) with FT2232H (USB 2.0, 8-bit) on the
    50T production board per updated Eagle schematic (commit 0db0e7b).
    USB 3.0 via FT601 remains available on the 200T premium board.
    - Add usb_data_interface_ft2232h.v: 245 Sync FIFO interface with toggle
    CDC (3-stage) for reliable 100MHz->60MHz clock domain crossing,
    mux-based byte serialization for 11-byte data packets, 26-byte status
    packets, and 4-byte sequential command read FSM
    - Add USB_MODE parameter to radar_system_top.v with generate block:
    USB_MODE=0 selects FT601 (200T), USB_MODE=1 selects FT2232H (50T)
    - Wire FT2232H ports in r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
2026-04-07 refactor(host): remove FT601 support from radar_protocol.py
    Strip all FT601/ftd3xx references from the core protocol module:
    - Remove FT601Connection class and ftd3xx import block
    - Remove _build_packets_ft601() 35-byte packet builder
    - Remove compact: bool parameter from RadarAcquisition
    - Remove dual-path parsing logic (compact vs FT601)
    - Rename parse_data_packet_compact -> parse_data_packet
    - Unify DATA_PACKET_SIZE to single 11-byte constant
    The 50T production board uses FT2232H exclusively.
    FT601 remains in out-of-scope legacy files (GUI_V6, etc).
2026-04-07 test: update test_radar_dashboard for FT2232H-only protocol
    Align test suite with FT601 removal from radar_protocol.py:
    - Replace FT601Connection with FT2232HConnection throughout
    - Rewrite _make_data_packet() to build 11-byte packets (was 35-byte)
    - Update data packet roundtrip test for 11-byte format
    - Fix truncation test threshold (20 -> 6 bytes, since packets are 11)
    - Update ReplayConnection frame_len assertions (35 -> 11 per packet)
    57 passed, 1 skipped (h5py), 0 failed.
2026-04-07 docs: update constraints README with USB_MODE architecture and build guide
    Add USB Interface Architecture section documenting the USB_MODE parameter,
    generate block mechanism, per-target wrapper pattern, FT2232H pin map, and
    build quick-reference. Update top modules table (50T now uses
    radar_system_top_50t), bank voltage tables, and signal differences to
    reflect the FT2232H/FT601 dual-interface design.
2026-04-07 docs(readme): add Alpha disclaimer to Key Features
    Core hardware works, but GPS/map integration, attitude correction,
    and beam steering UI are not yet complete — callers deserve to know
    before they build on those features.
    Closes gap 10.5 from reality-check review.
2026-04-08 fix: regenerate golden hex for dual-16pt Doppler and add real-data TBs to regression
    Regenerate all real-data golden reference hex files against the current
    dual 16-point FFT Doppler architecture (staggered-PRI sub-frames).
    The old hex files were generated against the previous 32-point single-FFT
    architecture and caused 2048/2048 mismatches in both strict real-data TBs.
    - Regenerate doppler_ref_i/q.hex, fullchain_doppler_ref_i/q.hex, and all
    downstream golden files (MTI, DC notch, CFAR) via golden_reference.py
    - Add tb_doppler_realdata (exact-match, ADI CN0566 data) to regression
    - Add tb_fullchain_realdata (exact-match, decim->Doppler chain) to regression
    - Both TBs now pass: 20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
2026-04-08 fix: align replay DC notch with dual sub-frame architecture
    The replay _replay_dc_notch() was treating all 32 Doppler bins as a
    single frame, only zeroing bins at the global edges ({0,1,31} for
    width=2). The RTL uses dual 16-point sub-frames where each sub-frame
    has its own DC, so the notch must use bin_within_sf = dbin & 0xF.
    This fixes test_replay_packets_parseable which was seeing 5 detections
    instead of the expected 4, due to a spurious hit at (range=2, doppler=15)
    surviving CFAR.
2026-04-09 docs(readme): replace text disclaimer with WIP badge
    Swap the verbose Alpha disclaimer paragraph for a simple
    "Features: Work in Progress" badge next to the existing
    Alpha badge, per review feedback from @JJassonn69.
    Badge links to the issues page for current status.
2026-04-09 Final touch (added via fencing and stop mask to ADTR1107 CPLR traces
2026-04-09 Ready for production
    Added Via fencing and stop mask to ADTR1107 CPLR traces
2026-04-12 fix: enforce strict ruff lint (17 rule sets) across entire repo
    - Expand ruff config from E/F to 17 rule sets (B, RUF, SIM, PIE, T20,
    ARG, ERA, A, BLE, RET, ISC, TCH, UP, C4, PERF)
    - Fix 907 lint errors across all Python files (GUI, FPGA cosim,
    schematics scripts, simulations, utilities, tools)
    - Replace all blind except-Exception with specific exception types
    - Remove commented-out dead code (ERA001) from cosim/simulation files
    - Modernize typing: deprecated typing.List/Dict/Tuple to builtins
    - Fix unused args/loop vars, ambiguous unicode, perf anti-patterns
    - Delete legacy GUI files V1-V4
    - Add V7 test suite, requirements files
    - All CI jobs pass: ruff (0 errors), py_compile, pytest (9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
2026-04-12 feat: add cross-layer contract tests (Python/Verilog/C) with CI job
    Three-tier test orchestrator validates opcode maps, bit widths, packet
    layouts, and round-trip correctness across FPGA RTL, Python GUI, and
    STM32 firmware. Catches 3 real bugs:
    - status_words[0] 37-bit truncation in both USB interfaces
    - Python radar_mode readback at wrong bit position (bit 21 vs 24)
    - RadarSettings.cpp buffer overread (min check 74 vs required 82)
    29 tests: 24 pass, 5 xfail (documenting confirmed bugs).
    4th CI job added: cross-layer-tests (Python + iverilog + cc).
2026-04-12 fix: resolve 3 cross-layer bugs (status_words truncation, mode readback, buffer overread)
    Bug 1 (FPGA): status_words[0] was 37 bits (8+3+2+5+3+16), silently
    truncated to 32. Restructured to {0xFF, mode[1:0], stream[2:0],
    3'b000, threshold[15:0]} = 32 bits exactly. Fixed in both
    usb_data_interface_ft2232h.v and usb_data_interface.v.
    Bug 2 (Python): radar_mode extracted at bit 21 but was actually at
    bit 24 after truncation — always returned 0. Updated shift/mask in
    parse_status_packet() to match new layout (mode>>22, stream>>19).
    Bug 3 (STM32): parseFromUSB() minimum size check was 74 bytes but
    9 doubles + uint32 + markers = 82 bytes. Buffer overread on last
    fields when 74-81 bytes passed.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
2026-04-13 feat: hybrid AGC (FPGA phases 1-3 + GUI phase 6) with timing fix
    FPGA:
    - rx_gain_control.v rewritten: per-frame peak/saturation tracking,
    auto-shift AGC with attack/decay/holdoff, signed gain -7 to +7
    - New registers 0x28-0x2C (agc_enable/target/attack/decay/holdoff)
    - status_words[4] carries AGC metrics (gain, peak, sat_count, enable)
    - DIG_5 GPIO outputs saturation flag for STM32 outer loop
    - Both USB interfaces (FT601 + FT2232H) updated with AGC status ports
    Timing fix (WNS +0.001ns -> +0.045ns, 45x improvement):
    - CIC max_fanout 4->16 on valid pipeline registers
    - +200ps setup uncertainty on 400MHz domain
    - ExtraNetDelay_high placement + AggressiveExplore routing
    GUI:
    - AGC opcodes +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
2026-04-13 feat: AGC phases 4-5 — STM32 outer-loop AGC class + main.cpp integration
    Implements the STM32 outer-loop AGC (ADAR1000_AGC) that reads the FPGA
    saturation flag on DIG_5/PD13 once per radar frame and adjusts the
    ADAR1000 VGA common gain across all 16 RX channels.
    Phase 4 — ADAR1000_AGC class (new files):
    - ADAR1000_AGC.h/.cpp: attack/recovery/holdoff logic, per-channel
    calibration offsets, effectiveGain() with OOB safety
    - test_agc_outer_loop.cpp: 13 tests covering saturation, holdoff,
    recovery, clamping, calibration, SPI spy, reset, mixed sequences
    Phase 5 — main.cpp integration:
    - Added #include and global outerAgc instance
    - AGC update+applyGain call between runRadarPulseSequen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
2026-04-13 feat: AGC phase 7 — AGC Monitor visualization tab with throttled redraws
    Add AGC Monitor tab to both tkinter and PyQt6 dashboards with:
    - Real-time strip charts: gain history, peak magnitude, saturation count
    - Color-coded indicator labels (green/yellow/red thresholds)
    - Ring buffer architecture (deque maxlen=256, ~60s at 10 Hz)
    - Fill-between saturation area with auto-scaling Y axis
    - Throttled matplotlib redraws (500ms interval via time.monotonic)
    to prevent GUI hang from 20 Hz mock-mode status packets
    Tests: 82 dashboard + 38 v7 = 120 total, all passing. Ruff: clean.
2026-04-13 fix: Python 3.12 GIL crash — queue-based cross-thread messaging for tkinter dashboard
    Replace all cross-thread root.after() calls with a queue.Queue drained by
    the main thread's _schedule_update() timer. _TextHandler no longer holds a
    widget reference; log append runs on the main thread via _drain_ui_queue().
    Also adds adi_agc_analysis.py — one-off bit-accurate RTL AGC simulation
    for ADI CN0566 raw IQ captures (throwaway diagnostic script).
2026-04-13 fix: 9 bugs from code review — RTL sign-ext & snapshot, thread safety, protocol fixes
    - rx_gain_control.v: sign-extension fix ({agc_gain[3],agc_gain} not {1'b0,agc_gain})
    + inclusive frame_boundary snapshot via combinational helpers (Bug #7)
    - v7/dashboard.py: Qt thread-safe logging via pyqtSignal bridge (Bug #1)
    + table headers corrected to 'Range (m)' / 'Velocity (m/s)' (Bug #2)
    - main.cpp: guard outerAgc.applyGain() with if(outerAgc.enabled) (Bug #3)
    - radar_protocol.py: replay L1 threshold detection when CFAR disabled (Bug #4)
    + IndexError guard in replay open (Bug #5) + AGC opcodes in _HARDWARE_ONLY_OPCODES
    - radar_dashboard.py: AGC monitor attribute name fixes (3 labels)
    - tb_r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
2026-04-13 fix: FPGA timing margins (WNS +0.002→+0.080ns) + 11 bug fixes from code review
    FPGA timing (400MHz domain WNS: +0.339ns, was +0.002ns):
    - DONT_TOUCH on BUFG to prevent AggressiveExplore cascade replication
    - NCO→mixer pipeline registers break critical 1.5ns route
    - Clock uncertainty reduced 200ps→100ps (adequate guardband)
    - Updated golden/cosim references for +1 cycle pipeline latency
    STM32 bug fixes:
    - Guard uint32_t underflow in processStartFlag (length<4)
    - Replace unbounded strcat in getSystemStatusForGUI with snprintf
    - Early-return error masking in checkSystemHealth
    - Add HAL_Delay in emergency blink loop
    GUI bug fixes:
    - Remove 0x03 from _HARDWARE_ONLY_OPCODES (was in both se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
2026-04-13 feat: Raw IQ Replay mode — software FPGA signal chain with playback controls
    Add a 4th connection mode to the V7 dashboard that loads raw complex IQ
    captures (.npy) and runs the full FPGA signal processing chain in software:
    quantize → AGC → Range FFT → Doppler FFT → MTI → DC notch → CFAR.
    Implementation (7 steps):
    - v7/agc_sim.py: bit-accurate AGC runtime extracted from adi_agc_analysis.py
    - v7/processing.py: RawIQFrameProcessor (full signal chain) + shared
    extract_targets_from_frame() for bin-to-physical conversion
    - v7/raw_iq_replay.py: RawIQReplayController with thread-safe playback
    state machine (play/pause/stop/step/seek/loop/FPS)
    - v7/workers.py: RawIQReplayWorker (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
2026-04-13 fix: 8 button-state bugs + wire radar position into replay for map display
    State machine fixes:
    1. Raw IQ replay EOF now calls _stop_radar() to fully restore UI
    2. Worker thread finished signal triggers UI recovery on crash/exit
    3. _stop_radar() stops demo simulator to prevent cross-mode interference
    4. _stop_demo() correctly identifies Mock mode via combo text
    5. Demo start no longer clobbers status bar when acquisition is running
    6. _stop_radar() resets playback button text, frame counter, file label
    7. _start_raw_iq_replay() error path cleans up stale controller/worker
    8. _refresh_gui() preserves Raw IQ paused status instead of overwriting
    Map/location:
    - RawIQReplayWorker now receives _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
2026-04-13 fix: playback state race condition, C-locale spinboxes, and Leaflet CDN loading
    - workers.py: Only emit playbackStateChanged on state transitions to
    prevent stale 'playing' signal from overwriting pause button text
    - dashboard.py: Force C locale on all QDoubleSpinBox instances so
    comma-decimal locales don't break numeric input; add missing
    'Saturation' legend label to AGC chart
    - map_widget.py: Enable LocalContentCanAccessRemoteUrls and set HTTP
    base URL so Leaflet CDN tiles/scripts load correctly in QtWebEngine
2026-04-13 fix: range calibration, demo/radar mutual exclusion, AGC analysis refactor
    Bug #1 — Range calibration for Raw IQ Replay:
    - Add WaveformConfig dataclass (models.py) with FMCW waveform params
    (fs, BW, T_chirp, fc) and methods to compute range/velocity resolution
    - Add waveform parameter spinboxes to playback controls (dashboard.py)
    - Auto-parse waveform params from ADI phaser filename convention
    - Create replay-specific RadarSettings with correct calibration instead
    of using FPGA defaults (781.25 m/bin → 0.334 m/bin for ADI phaser)
    - Add 4 unit tests validating WaveformConfig math
    Bug #2 — Demo + radar mutual exclusion:
    - _start_demo() now refuses if radar is running (_running=True)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
2026-04-14 feat: unified replay with SoftwareFPGA bit-accurate signal chain
    Add SoftwareFPGA class that imports golden_reference functions to
    replicate the FPGA pipeline in software, enabling bit-accurate replay
    of raw IQ, FPGA co-sim, and HDF5 recordings through the same
    dashboard path as live data.
    New modules: software_fpga.py, replay.py (ReplayEngine + 3 loaders)
    Enhanced: WaveformConfig model, extract_targets_from_frame() in
    processing, ReplayWorker with thread-safe playback controls,
    dashboard replay UI with transport controls and dual-dispatch
    FPGA parameter routing.
    Removed: ReplayConnection (from radar_protocol, hardware, dashboard,
    tests) — replaced by the unified replay architecture.
    15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
2026-04-14 feat: rename Tkinter dashboard to GUI_V65_Tk, add replay/demo/targets parity
    Rename radar_dashboard.py -> GUI_V65_Tk.py and add core feature parity
    with the v7 PyQt dashboard while keeping Tkinter as the framework:
    Replay mode:
    - _ReplayController with threading.Event-based play/pause/stop
    - Reuses v7.ReplayEngine and v7.SoftwareFPGA for all 3 input formats
    - Dual dispatch routes FPGA control opcodes to SoftwareFPGA during
    raw IQ replay; non-routable opcodes show user-visible status message
    - Seek slider with re-emit guard, speed combo, loop checkbox
    - close() properly releases engine file handles on stop/reload
    Demo mode:
    - DemoTarget kinematics scaled to physical range grid (~307m max)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
2026-04-14 Add UM982 GPS driver (um982_gps.h/.cpp) for NMEA sentence parsing and integration
2026-04-14 fix(mcu): escalate overtemp and watchdog-timeout faults to Emergency_Stop()
    handleSystemError() only called Emergency_Stop() for error codes in
    [ERROR_RF_PA_OVERCURRENT .. ERROR_POWER_SUPPLY] (9..13). Two critical
    faults were left out of the gate and fell through to attemptErrorRecovery()'s
    default log-and-continue branch:
    - ERROR_TEMPERATURE_HIGH (14): raised by checkSystemHealth() when the
    hottest of 8 PA thermal sensors exceeds 75 C. Without cutting bias
    (DAC CLR) and the PA 5V0/5V5/RFPA_VDD rails, the 10 W GaN QPA2962
    stages remain biased in an overtemperature state -- a thermal-runaway
    path in AERIS-10E.
    - ERROR_WATCHDOG_TIMEOUT (16): indicates the health-check loo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
2026-04-15 Revert "Add UM982 GPS driver (um982_gps.h/.cpp) for NMEA sentence parsing and…"
2026-04-15 feat(gps): add UM982 GPS driver replacing broken TinyGPS++
    Implement a complete UM982 GNSS driver (um982_gps.h/.c) with:
    - NMEA parser for GGA, RMC, THS, VTG with multi-talker support (GP/GN/GL/GA/GB)
    - Correct coordinate parsing using decimal-point-based degree detection
    (fixes PR #68 bug: 3-digit longitude degrees)
    - Checksum verification on all incoming sentences
    - Non-blocking line assembler with ring buffer
    - Init sequence: UNLOG, HEADING FIXLENGTH, baseline config, NMEA enables,
    VERSIONA handshake (no SAVECONFIG to avoid NVM wear)
    - Validity/age checks with configurable timeouts
    Integration into main.cpp:
    - Replace TinyGPSPlus with UM982_GPS_t, UART5 baud 9600->115200
    - Non-blocki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
2026-04-15 fix: resolve 3 deferred issues (STM32-006, STM32-004, FPGA-001)
    STM32-006: Remove blocking do-while loop that waited for legacy GUI start
    flag — production V7 PyQt GUI never sends it, hanging the MCU at boot.
    STM32-004: Check ad9523_init() return code and call Error_Handler() on
    failure, matching the pattern used by all other hardware init calls.
    FPGA-001: Simplify frame boundary detection to only trigger on
    chirp_counter wrap-to-zero. Previous conditions checking == N and == 2N
    were unreachable dead code (counter wraps at N-1). Now correct for any
    chirps_per_elev value.
2026-04-15 fix: use authoritative tx frame signal for frame sync, consistent ad9523 error path
    FPGA-001: The previous fix derived frame boundaries from chirp_counter==0,
    but that counter comes from plfm_chirp_controller_enhanced which overflows
    to N (not wrapping at chirps_per_elev). This caused frame pulses only on
    6-bit rollover (every 64 chirps) instead of every N chirps. Now wires the
    CDC-synchronized tx_new_chirp_frame_sync signal from the transmitter into
    radar_receiver_final, giving correct per-frame timing for any N.
    STM32-004: Changed ad9523_init() failure path from Error_Handler() to
    return -1, matching the pattern used by ad9523_setup() and ad9523_status()
    in the same function. Both halt th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
2026-04-16 fix(cosim): align golden_reference ADC sign conversion with RTL
    The golden reference used (adc_val - 128) << 9 which subtracts 65536,
    but the Verilog RTL computes {1'b0,adc,9'b0} - {1'b0,8'hFF,9'b0}/2
    which subtracts 0xFF00 = 65280. This creates a constant 256-LSB DC
    offset between the golden reference and RTL for all 256 ADC values.
    The bit-accurate model in fpga_model.py already uses the correct RTL
    formula. This aligns golden_reference.py to match.
    Verified: all 256 ADC input values now produce zero offset against
    fpga_model.py.
2026-04-16 feat(fpga): make FT2232H default USB interface, rewrite FT601 write FSM, add clock-loss watchdog
    - Set USB_MODE default to 1 (FT2232H) in radar_system_top.v; 200T build
    overrides to USB_MODE=0 via build_200t.tcl generic property
    - Rewrite FT601 write FSM: 4-state architecture with 3-word packed data,
    pending-flag gating, and frame sync counter
    - Add FT2232H read FSM rd_cmd_complete flag, stream field zeroing, and
    range_data_ready 1-cycle pipeline delay in both USB modules
    - Implement clock-loss watchdog: ft_heartbeat toggle + 16-bit timeout
    counter drives ft_clk_lost, feeding ft_effective_reset_n via 2-stage
    ASYNC_REG synchronizer chain
    - Fix sample_counter reset literal width (11'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
2026-04-16 feat(gui): add FT601Connection class, USB interface selection in V65/V7
    - Add FT601Connection in radar_protocol.py using ftd3xx library with
    proper setChipConfiguration re-enumeration handling (close, wait 2s,
    re-open) and 4-byte write alignment
    - Add USB Interface dropdown to V65 Tk GUI (FT2232H default, FT601 option)
    - Add USB Interface combo to V7 PyQt dashboard with Live/File mode toggle
    - Fix mock frame_start bit 7 in both FT2232H and FT601 connections
    - Use FPGA range data from USB packets instead of recomputing in Python
    - Export FT601Connection from v7/hardware.py and v7/__init__.py
    - Add 7 FT601Connection tests (91 total in test_GUI_V65_Tk.py)
2026-04-16 fix(tests): update cross-layer tests for frame_start bit and stream-gated mux
    - TB byte 9 check: expect 0x81 (frame_start=1 after reset + cfar=1)
    - contract_parser: handle ternary expressions in data_pkt_byte mux
    (stream_doppler_en ? doppler_real_cap : 8'd0 pattern)
    - contract_parser: handle intermediate variable pattern for detection
    field (det_byte = raw[9]; detection = det_byte & 0x01)
2026-04-16 fix: clarify comments — AGC width, dual-USB docstring, BE datasheet ref
2026-04-16 fix(gui): align radar parameters to FPGA truth (radar_scene.py)
    - Bandwidth 500 MHz -> 20 MHz, sample rate 4 MHz -> 100 MHz (DDC output)
    - Range formula: deramped FMCW -> matched-filter c/(2*Fs)*decimation
    - Velocity formula: use PRI (167 us) and chirps_per_subframe (16)
    - Carrier frequency: 10.525 GHz -> 10.5 GHz per radar_scene.py
    - Range per bin: 4.8 m -> 24 m, max range: 307 m -> 1536 m
    - Fix simulator target spawn range to match new coverage (50-1400 m)
    - Remove dead BANDWIDTH constant, add SAMPLE_RATE to V65 Tk
    - All 174 tests pass, ruff clean
2026-04-16 fix: propagate FPGA AGC enable to MCU outer loop via DIG_6 GPIO
    Resolve cross-layer AGC control mismatch where opcode 0x28 only
    controlled the FPGA inner-loop AGC but the STM32 outer-loop AGC
    (ADAR1000_AGC) ran independently with its own enable state.
    FPGA: Drive gpio_dig6 from host_agc_enable instead of tied low,
    making the FPGA register the single source of truth for AGC state.
    MCU: Change ADAR1000_AGC constructor default from enabled(true) to
    enabled(false) so boot state matches FPGA reset default (AGC off).
    Read DIG_6 GPIO every frame with 2-frame confirmation debounce to
    sync outerAgc.enabled — prevents single-sample glitch from causing
    spurious AGC state transitions.
    Tests: Update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
2026-04-16 test(cross-layer): enforce 2-frame DIG_6 debounce guard on outerAgc.enabled
    PR #93 added a 2-frame confirmation debounce so a single-sample GPIO
    glitch cannot flip MCU outer-loop AGC state. The debounce is load-bearing
    for the "prevents a single-sample glitch" guarantee in the PR body, but
    no existing test enforces its structure — test_mcu_reads_dig6_before_agc_gate
    only checks that HAL_GPIO_ReadPin(FPGA_DIG6, ...) and `outerAgc.enabled =`
    appear somewhere in main.cpp, which a naive direct assignment would still
    pass.
    Add test_mcu_dig6_debounce_guards_enable_assignment to
    TestTier1AgcCrossLayerInvariant, verifying four structural invariants of
    the debounce:
    1. Current DIG_6 sample capt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
2026-04-16 chore(mcu): remove dead C-style adar1000 driver
    The firmware uses the C++ ADAR1000_Manager class exclusively. The C-style
    driver pair (adar1000.c, 693 LoC; adar1000.h, 294 LoC) has no external
    call sites:
    grep -rn "Adar_Set|Adar_Read|Adar_Write|Adar_Soft" 9_Firmware
    grep -rn "AdarDevice|AdarBiasCurrents|AdarDeviceInfo" 9_Firmware
    Both return hits only inside adar1000.c/h themselves. ADAR1000_Manager.h
    has its own copies of REG_CH1_*, REG_INTERFACE_CONFIG_A, etc. and does
    not include adar1000.h. main.cpp had a lone #include "adar1000.h" but
    referenced no symbols from it; the REG_* macros it uses resolve through
    ADAR1000_Manager.h on the next line.
    No behaviour change: the deleted code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
2026-04-17 docs(readme): correct BOM sensor counts and locations
    The STM32 peripheral list in the README disagreed with the production
    BOM (4_7_Production Files/Gerber_Main_Board/RADAR_Main_Board_BOM_csv)
    and with the firmware (9_1_Microcontroller/.../main.cpp). Corrections
    based on origin/main commit 754d919:
    - ADS7830 Idq ADCs: placed on the Main Board (U88 @ 0x48, U89 @ 0x4A),
    not on the Power Amplifier Boards. Added the INA241A3 (x50) and 5 mOhm
    shunt detail that completes the current-sense chain.
    - DAC5578 Vg DACs: placed on the Main Board (U7 @ 0x48, U69 @ 0x49),
    not on the Power Amplifier Boards. Noted closed-loop Idq calibration
    at boot (main.cpp powerUpSequence).
    - Temperature sensors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
2026-04-17 fix(adar1000): populate VM_I/VM_Q phase tables; remove dead VM_GAIN
    The ADAR1000 vector-modulator I/Q lookup tables VM_I[128] and VM_Q[128]
    were declared but defined as empty initialiser lists since the first
    commit (5fbe97f). Every call to adarSetRxPhase / adarSetTxPhase therefore
    wrote (I=0x00, Q=0x00) to registers 0x21/0x23 (Rx) and 0x32/0x34 (Tx)
    regardless of the requested phase state, leaving beam steering completely
    non-functional in firmware.
    This commit:
    * Populates VM_I[128] and VM_Q[128] from ADAR1000 datasheet Rev. B
    Tables 13-16 (p.34) on a uniform 2.8125 deg grid (360 / 128 states).
    Byte format: bits[7:6] reserved 0, bit[5] polarity (1 = positive
    lobe), bits[4:0] 5-bit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
2026-04-22 Added BOM and Gerbers
    BOM and Gerbers, ready to be sent to PCB manufacturer
2026-04-23 Add Mechanical parts
    Add Mechanical parts (Waveguide and heat sinks)
2026-06-17 Add files via upload
    Pulled high the Enable Pin of the 2 opamps (pin 15) + changed value of the crystal load capacitors
